andvoy/steering-wheel-heater/(commit log)

2026-08-31 Add release 1.1: steering-wheel-heater-1.1.html
2026-08-31 Add release 1.1: firmware/steering_wheel_heater_v1_1-optiboot.hex
2026-08-31 Add release 1.1: firmware/steering_wheel_heater_v1_1/steering_wheel_heater_v1_1.hex
2026-08-31 Add release 1.1: firmware/steering_wheel_heater_v1_1/steering_wheel_heater_v1_1.ino
2026-10-15 Release 1.2: add firmware/steering_wheel_heater_v1_2/steering_wheel_heater_v1_2.ino
2026-10-15 Release 1.2: add firmware/steering_wheel_heater_v1_2/steering_wheel_heater_v1_2.hex
2026-10-15 Release 1.2: add firmware/steering_wheel_heater_v1_2-optiboot.hex
2026-10-15 Release 1.2: add steering-wheel-heater-1.2.html
2026-10-16 Release 1.3: 42 V measured heater profile and configurable firmware
2026-10-23 Release 1.4: built-in LED fault codes and persistent diagnostic reasons
2026-10-26 Release 1.9: unified temperature control and bilingual documentation
2026-10-26 Document VIN power supply and update schematic and perfboard wiring
